TheTechCompany/hive-leaf/MIDI_Sprout_circuitboard_v008.png

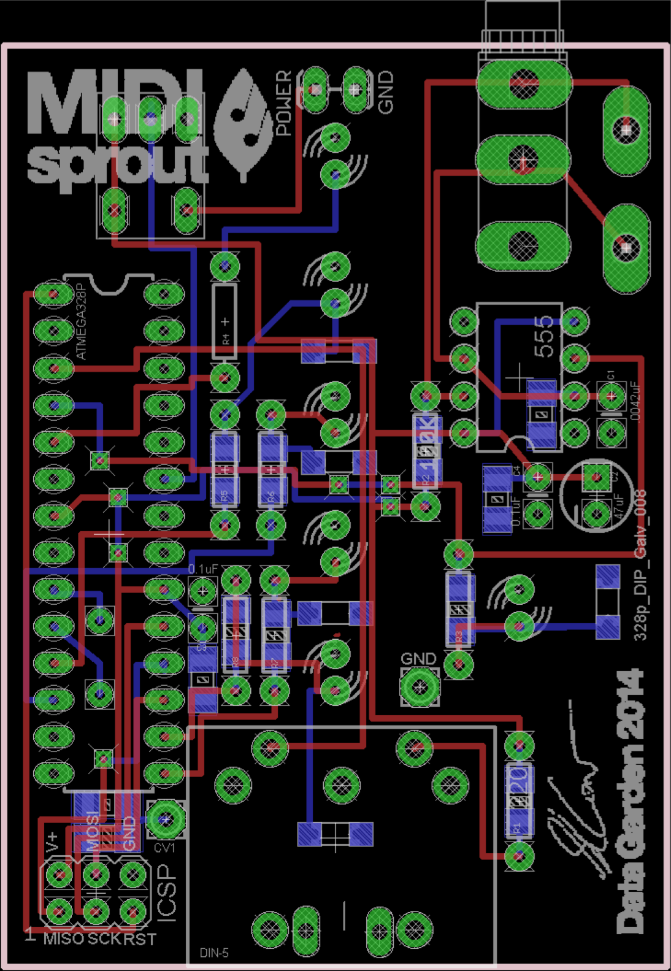
MIDI_Sprout_circuitboard_v008.png
