TheTechCompany/hive-leaf/README.md

# MIDIsprout

Welcome to this repository for code and designs of the MIDI Sprout Biodata Sonification system
