TheTechCompany/hive-leaf/MIDI Sprout Schematic.png

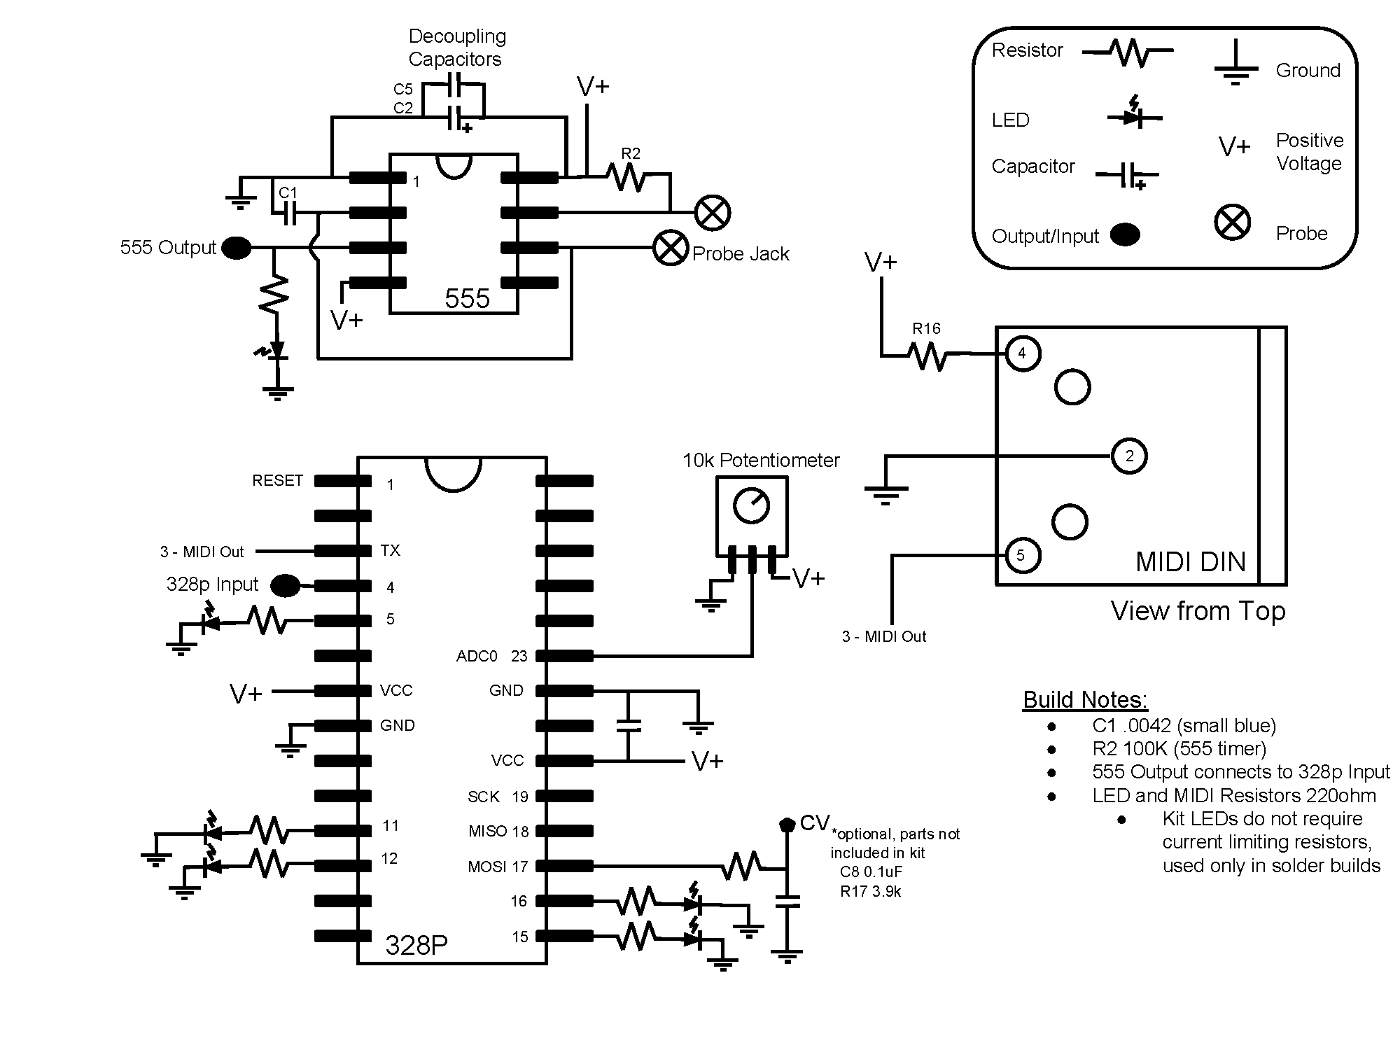
MIDI Sprout Schematic.png
