TheTechCompany/hive-leaf/MIDI_Sprout_Schematic_008.png

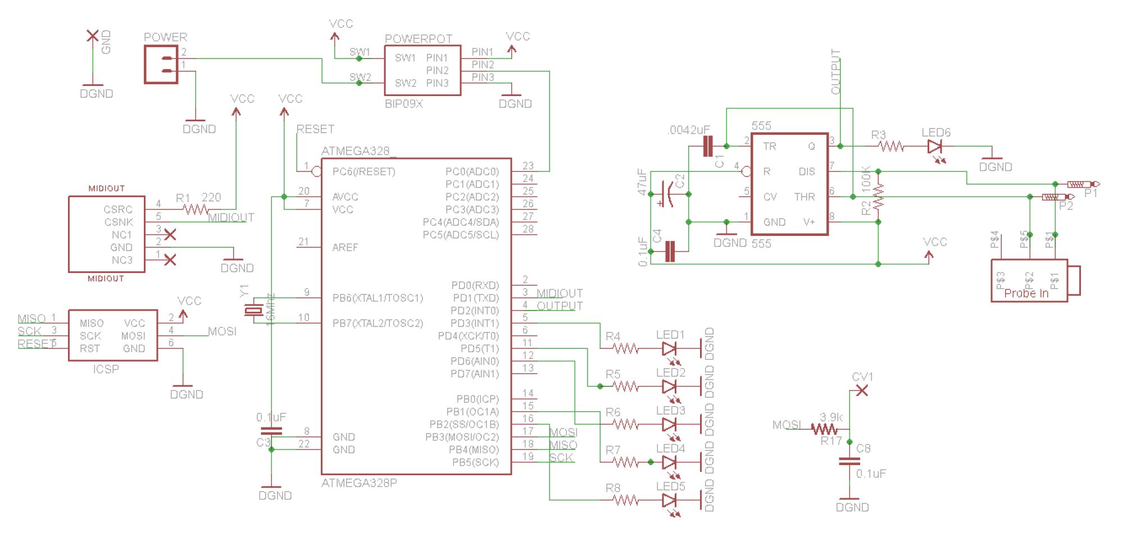
MIDI_Sprout_Schematic_008.png
