TheTechCompany/hive-leaf/Enclosure_top_plant.stl

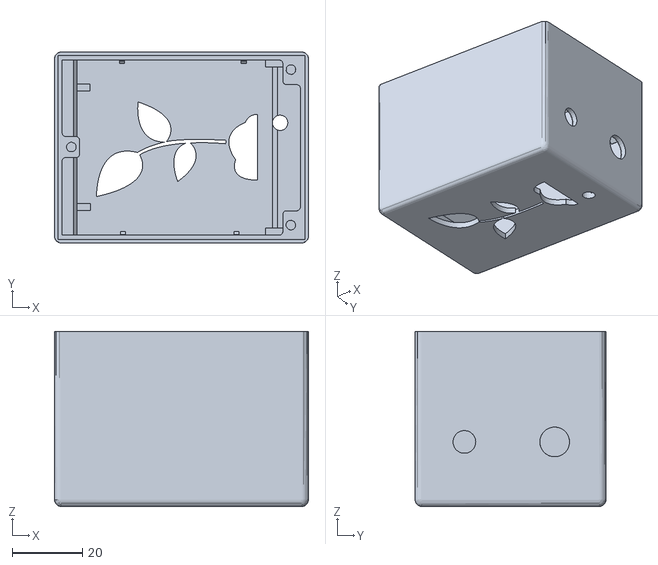
[picture p4: CAD file, 2021-06-30]
Enclosure_top_plant.stl
72.5 x 54.5 x 50.0
