TheTechCompany/hive-leaf/Enclosure_btm_studs.stl

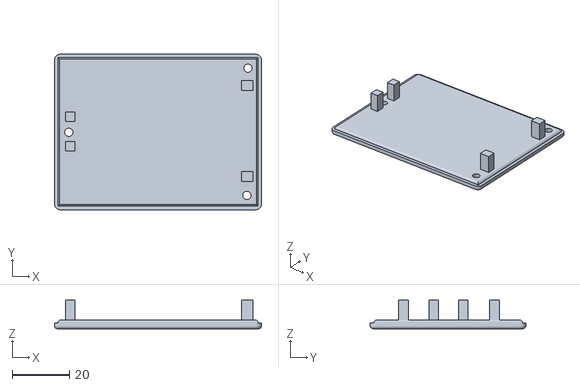
[picture p5: CAD file, 2021-06-30]
Enclosure_btm_studs.stl
72.5 x 54.5 x 10.0
