TheTechCompany/hive-leaf/MIDI_Sprout_009_gerber/328p_DIP_Galv_009_gnd.brd

## EAGLE design MIDI_Sprout_009_gerber/328p_DIP_Galv_009_gnd.brd (2021-06-30)

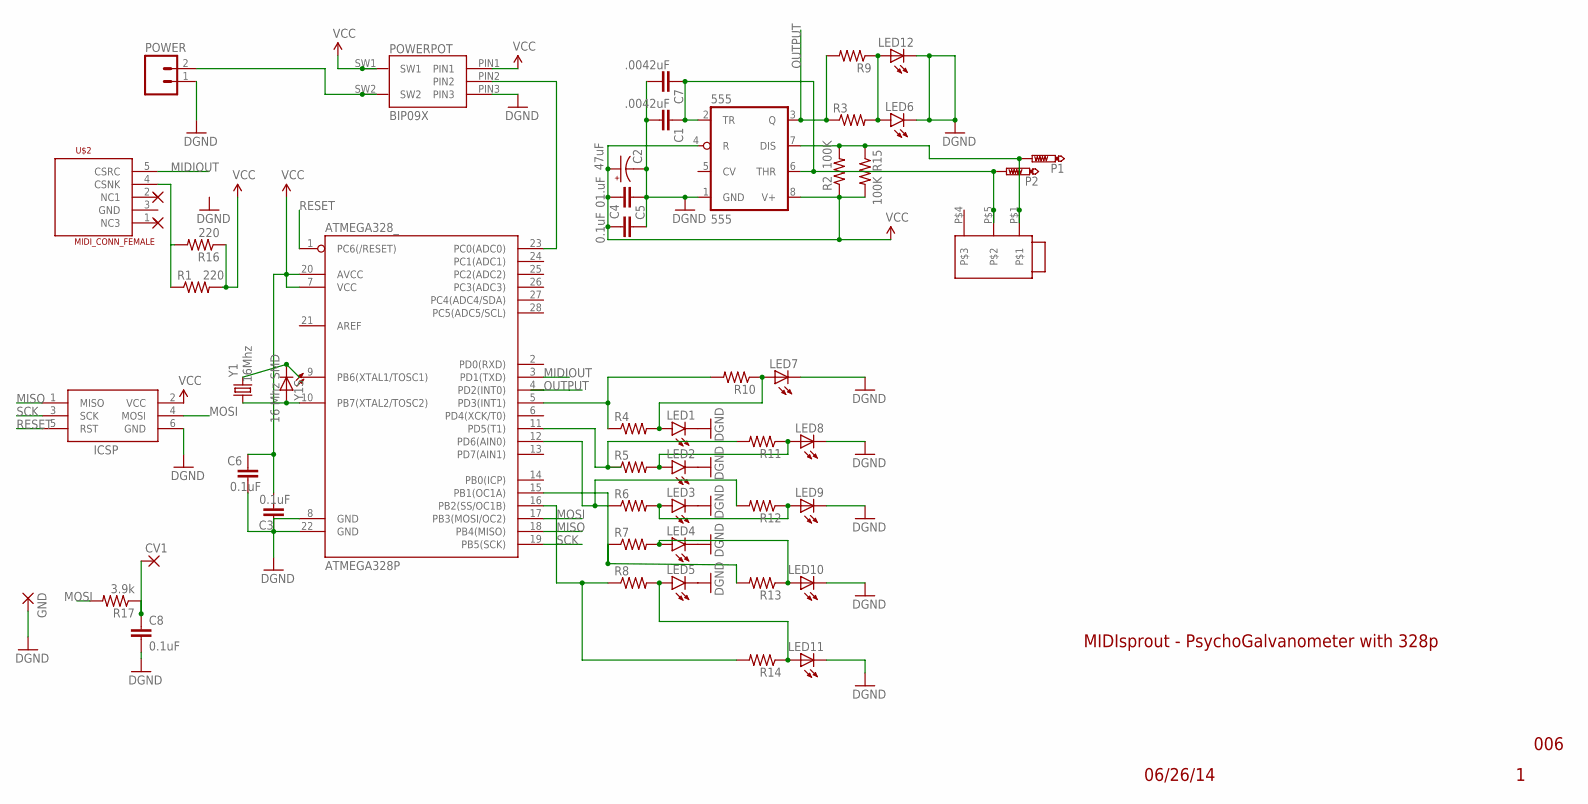
[picture p6: schematic 328p_DIP_Galv_009_gnd.sch]

Parts:
555: 555; DIL08-ROUND
ATMEGA328_: ATMEGA328P; DIL28-3
C1: .0042uF; CAP-PTH-SMALL
C2: 47uF; CPOL-RADIAL-10UF-25V
C3, C4: 0.1uF; CAP-PTH-SMALL
C5: 01.uF; 1206
C6, C8: 0.1uF; 1206
C7: .0042uF; 1206
CV1: 2,54/1,1
GND: 2,54/1,1
ICSP: AVRISP-6; AVRISP
LED1, LED2, LED3, LED4, LED5, LED6: LED5MM
LED7, LED8, LED9, LED10, LED11, LED12: LEDSML1206; SML1206
P1, P2: PTR1PAD1-20Y; P1-20Y
POWER: M02LOCK_LONGPADS; 1X02_LOCK_LONGPADS
POWERPOT: BIP09X
R1: 220; AXIAL-0.3
R2: 100K; AXIAL-0.3
R3, R4, R5, R6, R7, R8: RESISTORAXIAL-0.3; AXIAL-0.3
R9, R10, R11, R12, R13, R14: R-US_R1206; R1206
R15: 100K; R1206
R16: 220; R1206
R17: 3.9k; R1206
U$1: MONOJACK; MONOJACK_SWCR_3.5
U$2: MIDI_CONN_FEMALE; DIN_5_FEMALE
Y1: 16Mhz; HC49US
Y1S: 16 Mhz SMD; SML1206

Connections:
GND: 555.1 (GND), ATMEGA328_.8 (GND), ATMEGA328_.22 (GND), C1.2, C2.2 (-), C3.1, C4.2, C5.1, C6.2, C7.2, C8.2, GND.1, ICSP.6 (GND), LED1.K (C), LED2.K (C), LED3.K (C), LED4.K (C), LED5.K (C), LED6.K (C), LED7.C, LED8.C, LED9.C, LED10.C, LED11.C, LED12.C, POWER.1, POWERPOT.PIN3
MIDIOUT: ATMEGA328_.3 (PD1(TXD)), U$2.5 (CSRC)
MISO: ATMEGA328_.18 (PB4(MISO)), ICSP.1 (MISO)
MOSI: ATMEGA328_.17 (PB3(MOSI/OC2)), ICSP.4 (MOSI), R17.2
unnamed: C8.1, CV1.1, R17.1
unnamed: ATMEGA328_.10 (PB7(XTAL2/TOSC2)), Y1.1, Y1S.A
unnamed: ATMEGA328_.9 (PB6(XTAL1/TOSC1)), Y1.2, Y1S.C
unnamed: ATMEGA328_.23 (PC0(ADC0)), POWERPOT.PIN2
unnamed: R1.P$1 (1), R16.2, U$2.4 (CSNK)
unnamed: ATMEGA328_.5 (PD3(INT1)), R4.P$1 (1), R10.2
unnamed: ATMEGA328_.11 (PD5(T1)), R5.P$1 (1), R11.2
unnamed: ATMEGA328_.12 (PD6(AIN0)), R6.P$1 (1), R12.2
unnamed: POWER.2, POWERPOT.SW2
unnamed: ATMEGA328_.15 (PB1(OC1A)), R7.P$1 (1), R13.2
unnamed: ATMEGA328_.16 (PB2(SS/OC1B)), R8.P$1 (1), R14.2
unnamed: LED1.A, LED7.A, R4.P$2 (2), R10.1
unnamed: LED2.A, LED8.A, R5.P$2 (2), R11.1
unnamed: LED3.A, LED9.A, R6.P$2 (2), R12.1
unnamed: LED4.A, LED10.A, R7.P$2 (2), R13.1
unnamed: LED5.A, LED11.A, R8.P$2 (2), R14.1
unnamed: LED6.A, LED12.A, R3.P$2 (2), R9.1
OUTPUT: 555.3 (Q), ATMEGA328_.4 (PD2(INT0)), R3.P$1 (1), R9.2
PROBE1: 555.2 (TR), 555.6 (THR), C1.1, C7.1, P2.TP, U$1.P$5
PROBE2: 555.7 (DIS), P1.TP, R2.P$2 (2), R15.1, U$1.P$1
RESET: ATMEGA328_.1 (PC6(/RESET)), ICSP.5 (RST)
SCK: ATMEGA328_.19 (PB5(SCK)), ICSP.3 (SCK)
VCC: 555.4 (R), 555.8 (V+), ATMEGA328_.7 (VCC), ATMEGA328_.20 (AVCC), C2.1 (+), C3.2, C4.1, C5.2, C6.1, ICSP.2 (VCC), POWERPOT.PIN1, POWERPOT.SW1, R1.P$2 (2), R2.P$1 (1), R15.2, R16.1

Notes on the sheet:
06/26/14
006
MIDIsprout - PsychoGalvanometer with 328p

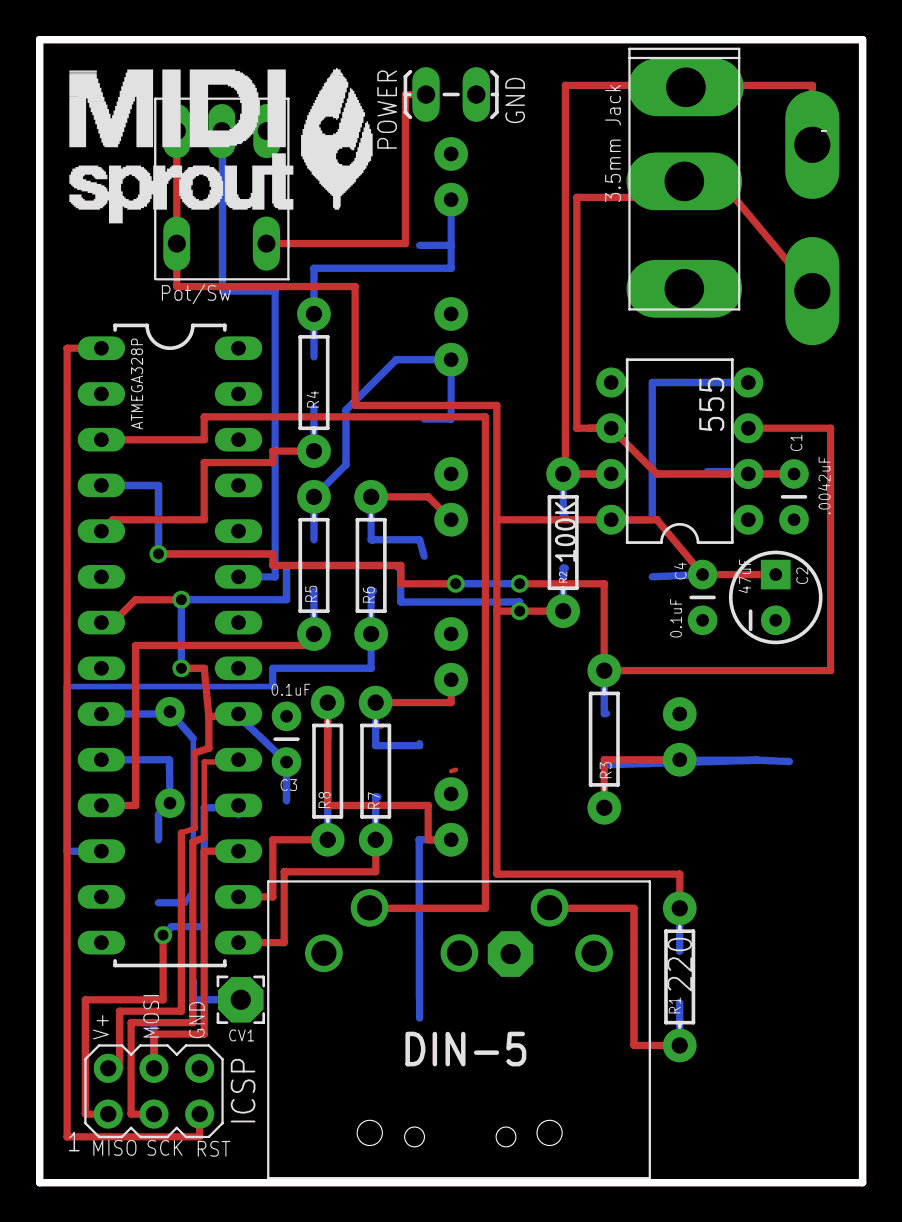
[picture p7: board 328p_DIP_Galv_009_gnd.brd from above]

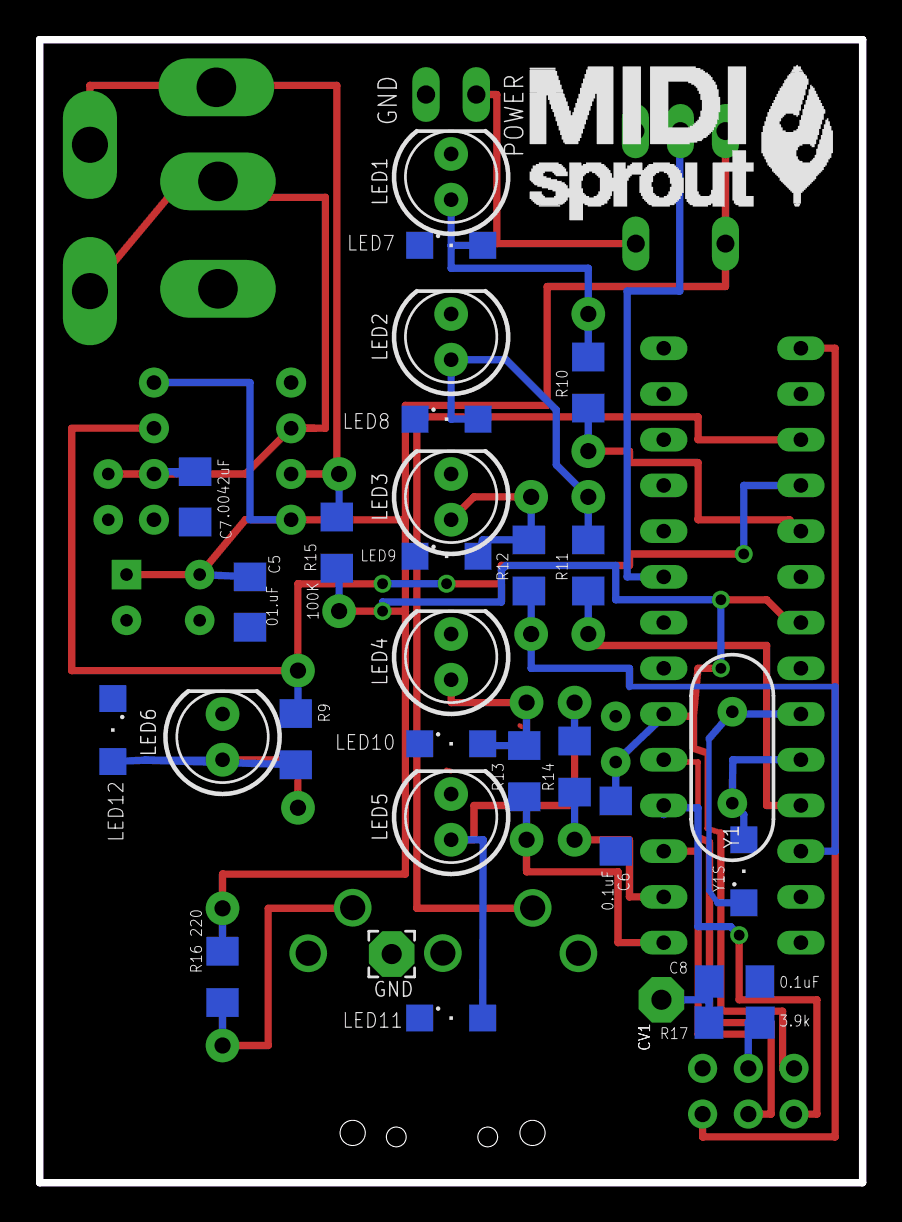
[picture p8: board 328p_DIP_Galv_009_gnd.brd from below]

Board: 2 copper layers, 45.7 x 63.5 mm, 50 parts (28 on the bottom side), 27 nets.
