TheTechCompany/hive-leaf/MIDI_Psychogalv_328p_v021/MIDI_Psychogalv_328p_v021.ino

/*------------
MIDI_PsychoGalvanometer v021
Accepts pulse inputs from a Galvanic Conductance sensor 
consisting of a 555 timer set as an astablemultivibrator and two electrodes. 
Through sampling pulse widths and identifying fluctuations, MIDI note and control messages 
are generated.  Features include Threshold, Scaling, Control Number, and Control Voltage 
using PWM through an RC Low Pass filter.
MIDIsprout.com
-------------*/

#include <LEDFader.h> //manage LEDs without delay() jgillick/arduino-LEDFader https://github.com/jgillick/arduino-LEDFader.git

//******************************
//set scaled values, sorted array, first element scale length
int scaleMajor[]  = {7,1, 3, 5, 6, 8, 10, 12};
int scaleDiaMinor[]  = {7,1, 3, 4, 6, 8, 9, 11};
int scaleIndian[]  = {7,1, 2, 2, 5, 6, 9, 11};
int scaleMinor[]  = {7,1, 3, 4, 6, 8, 9, 11};
int scaleChrom[] = {12,1,2,3,4,5,6,7,8,9,10,11,12};
int *scaleSelect = scaleChrom; //initialize scaling
int root = 0; //initialize for root
//*******************************

const byte interruptPin = INT0; //galvanometer input
const byte knobPin = A0; //knob analog input

const byte samplesize = 10; //set sample array size
const byte analysize = samplesize - 1;  //trim for analysis array

const byte polyphony = 5; //above 8 notes may run out of ram
byte channel = 1;  //setting channel to 11 or 12 often helps simply computer midi routing setups
int noteMin = 36; //C2  - keyboard note minimum
int noteMax = 96; //C7  - keyboard note maximum
byte QY8= 0;  //sends each note out chan 1-4, for use with General MIDI like Yamaha QY8 sequencer
byte controlNumber = 80; //set to mappable control, low values may interfere with other soft synth controls!!
byte controlVoltage = 1; //output PWM CV on controlLED, pin 17, PB3, digital 11 *lowpass filter
long batteryLimit = 3000; //voltage check minimum, 3.0~2.7V under load; causes lightshow to turn off (save power)
byte checkBat = 1;

volatile unsigned long microseconds; //sampling timer
volatile byte index = 0;
volatile unsigned long samples[samplesize];

float threshold = 2.3;  //change threshold multiplier
float threshMin = 1.61; //scaling threshold min
float threshMax = 3.71; //scaling threshold max
float knobMin = 1;
float knobMax = 1023;

unsigned long previousMillis = 0;
unsigned long currentMillis = 1;
unsigned long batteryCheck = 0; //battery check delay timer
 
#define LED_NUM 6
LEDFader leds[LED_NUM] = { // 6 LEDs (perhaps 2 RGB LEDs)
  LEDFader(3),
  LEDFader(5),
  LEDFader(6),
  LEDFader(9),
  LEDFader(10),
  LEDFader(11)  //Control Voltage output or controlLED
};
int ledNums[LED_NUM] = {3,5,6,9,10,11};
byte controlLED = 5; //array index of control LED (CV out)
byte noteLEDs = 1;  //performs lightshow set at noteOn event

typedef struct _MIDImessage { //build structure for Note and Control MIDImessages
  unsigned int type;
  int value;
  int velocity;
  long duration;
  long period;
  int channel;
} 
MIDImessage;
MIDImessage noteArray[polyphony]; //manage MIDImessage data as an array with size polyphony
int noteIndex = 0;
MIDImessage controlMessage; //manage MIDImessage data for Control Message (CV out)


void setup()
{
  pinMode(knobPin, INPUT);
  randomSeed(analogRead(0)); //seed for QY8 
  Serial.begin(31250);  //initialize at MIDI rate
  controlMessage.value = 0;  //begin CV at 0
  //MIDIpanic(); //dont panic, unless you are sure it is nessisary
  checkBattery(); // shut off lightshow if power is too low
  if(noteLEDs) bootLightshow(); //a light show to display on system boot
  attachInterrupt(interruptPin, sample, RISING);  //begin sampling from interrupt
  
}

void loop()
{
  currentMillis = millis();   //manage time
  checkBattery(); //on low power, shutoff lightShow, continue MIDI operation
  checkKnob(); //check knob value
  if(index >= samplesize)  { analyzeSample(); }  //if samples array full, also checked in analyzeSample(), call sample analysis   
  checkNote();  //turn off expired notes 
  checkControl();  //update control value
  //checkButton();  //not implemented in this build
  checkLED();  //LED management without delay()
  previousMillis = currentMillis;   //manage time
}
