TheTechCompany/hive-leaf/MIDI_Psychogalv_328p_v021/SampleAnalysis.ino

//interrupt timing sample array
void sample()
{
  if(index < samplesize) {
    samples[index] = micros() - microseconds;
    microseconds = samples[index] + microseconds; //rebuild micros() value w/o recalling
    //micros() is very slow
    //try a higher precision counter
    //samples[index] = ((timer0_overflow_count << 8) + TCNT0) - microseconds;
    index += 1;
  }
}



void analyzeSample()
{
  //eating up memory, one long at a time!
  unsigned long averg = 0;
  unsigned long maxim = 0;
  unsigned long minim = 100000;
  float stdevi = 0;
  unsigned long delta = 0;
  byte change = 0;

  if (index == samplesize) { //array is full
    unsigned long sampanalysis[analysize];
    for (byte i=0; i<analysize; i++){ 
      //skip first element in the array
      sampanalysis[i] = samples[i+1];  //load analysis table (due to volitle)
      //manual calculation
      if(sampanalysis[i] > maxim) { maxim = sampanalysis[i]; }
      if(sampanalysis[i] < minim) { minim = sampanalysis[i]; }
      averg += sampanalysis[i];
      stdevi += sampanalysis[i] * sampanalysis[i];  //prep stdevi
    }

    //manual calculation
    averg = averg/analysize;
    stdevi = sqrt(stdevi / analysize - averg * averg); //calculate stdevu
    if (stdevi < 1) { stdevi = 1.0; } //min stdevi of 1
    delta = maxim - minim; 
    
    //**********perform change detection 
    if (delta > (stdevi * threshold)){
      change = 1;
    }
    //*********
    
    if(change){// set note and control vector
       int dur = 150+(map(delta%127,1,127,100,2500)); //length of note
       int ramp = 3 + (dur%100) ; //control slide rate, min 25 (or 3 ;)
       int notechannel = random(1,5); //gather a random channel for QY8 mode
       
       //set scaling, root key, note
       int setnote = map(averg%127,1,127,noteMin,noteMax);  //derive note, min and max note
       setnote = scaleNote(setnote, scaleSelect, root);  //scale the note
       // setnote = setnote + root; // (apply root?)
       if(QY8) { setNote(setnote, 100, dur, notechannel); } //set for QY8 mode
       else { setNote(setnote, 100, dur, channel); }
  
       //derive control parameters and set    
       setControl(controlNumber, controlMessage.value, delta%127, ramp); //set the ramp rate for the control
     }
     //reset array for next sample
    index = 0;
  }
}
